LineFJAED/LineFollowerJAED/Diseño de implementación de componentes.jpeg

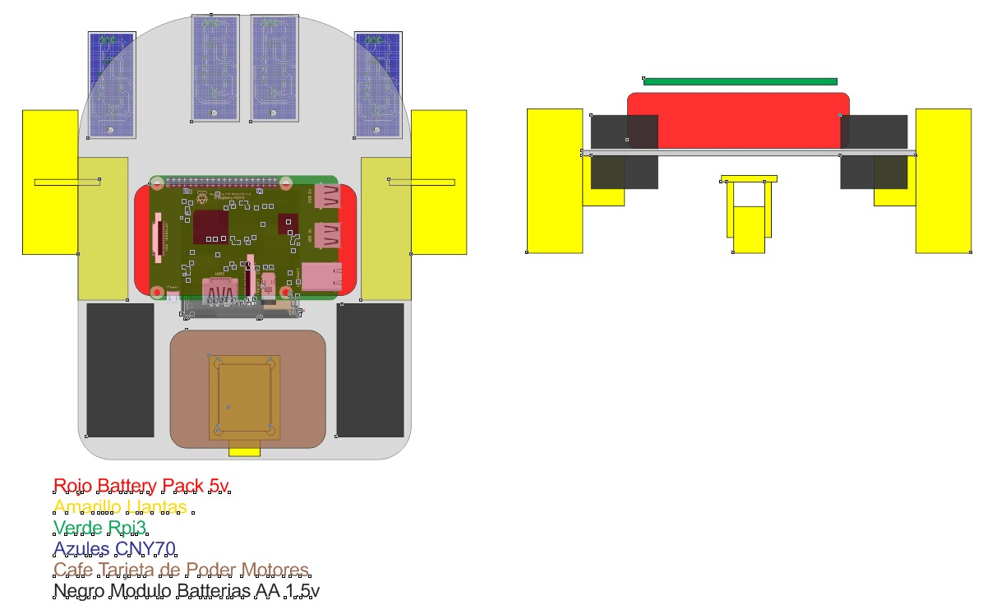
Diseño de implementación de componentes.jpeg
