LineFJAED/LineFollowerJAED/README.md

# LineFollowerJAED
Proyecto de código abierto, seguidor de línea, y proyecto de módulo.
