LineFJAED/LineFollowerJAED/Diseño de tornillos Inkscape.jpeg

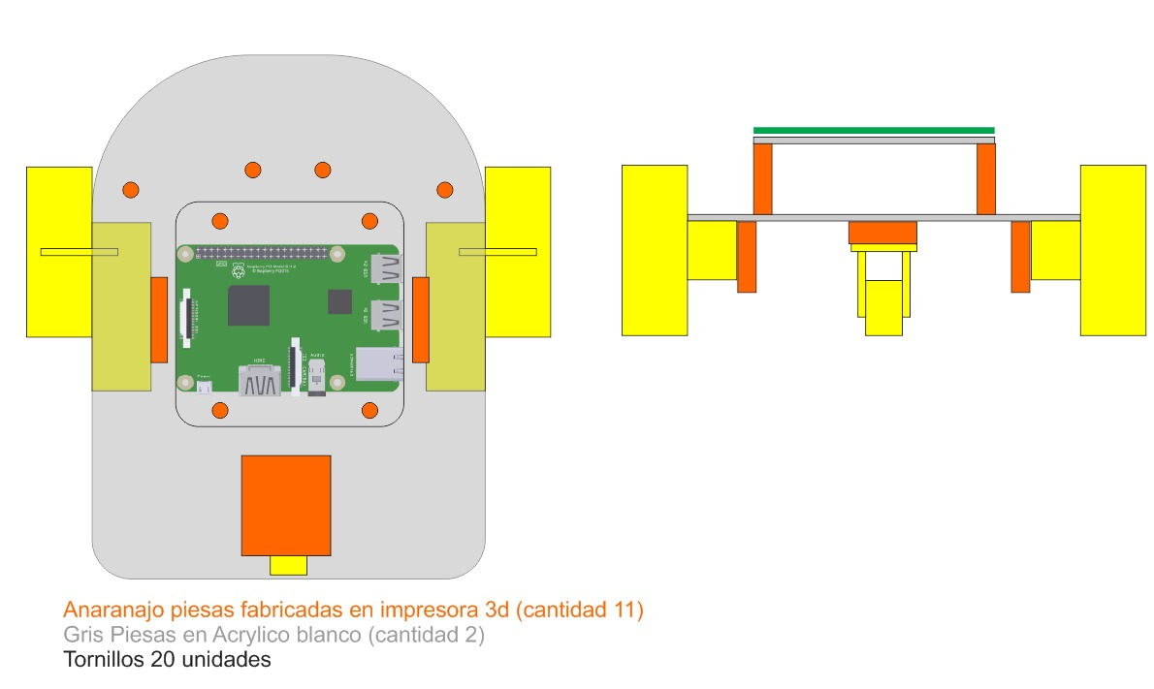
Diseño de tornillos Inkscape.jpeg
