LineFJAED/LineFollowerJAED/proyecto.pdf

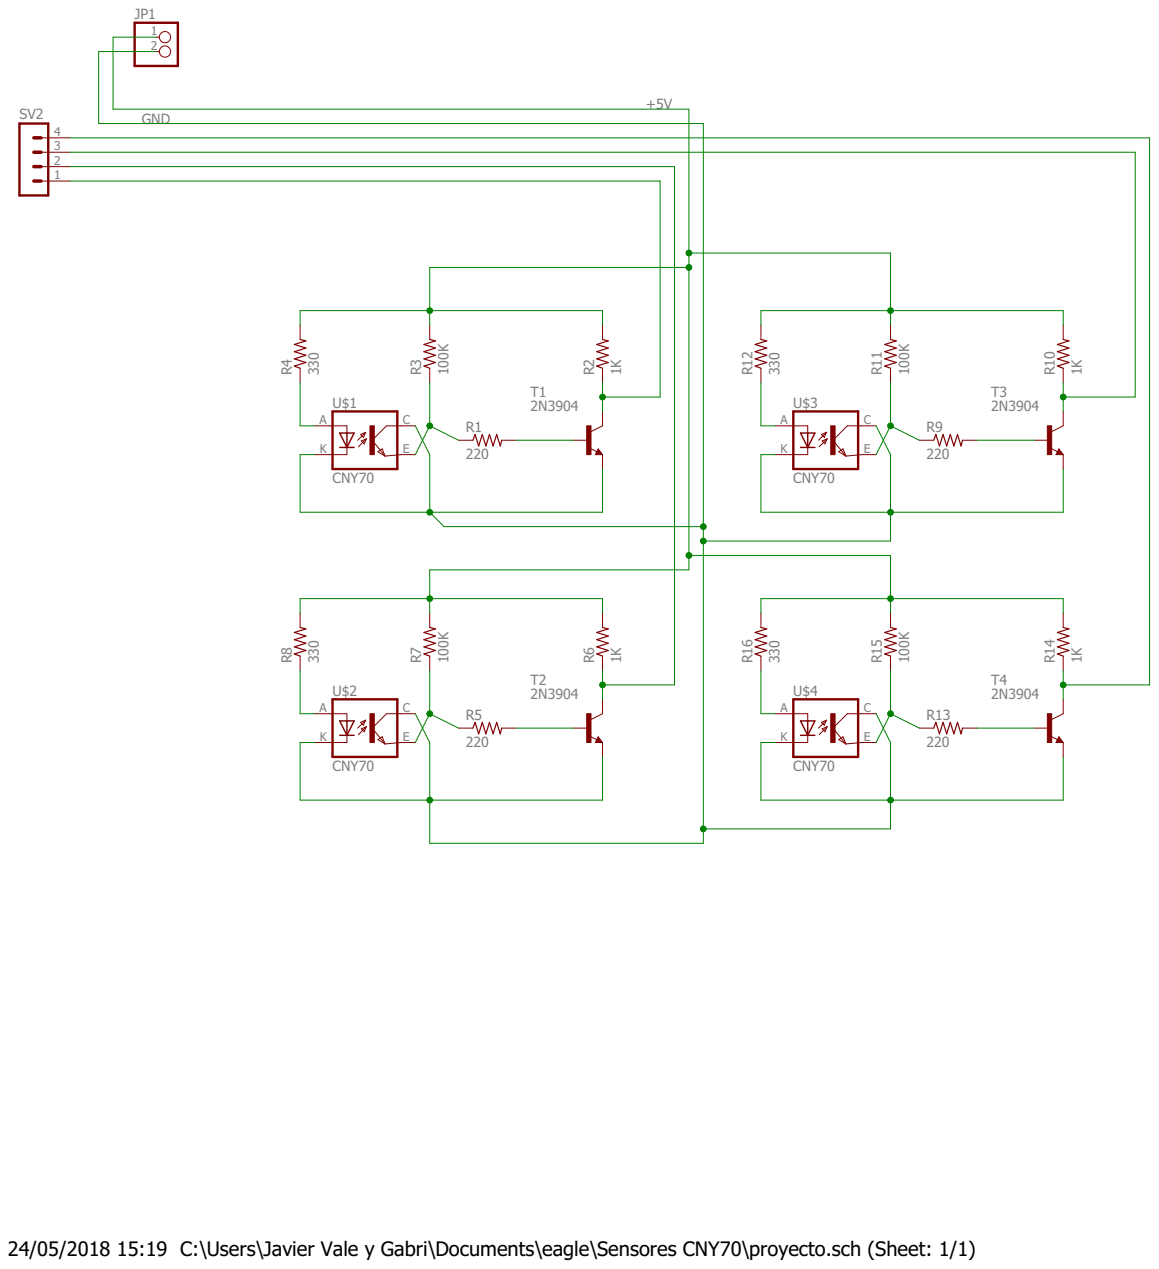
[picture p4: page 1]

24/05/2018 15:19 C:\Users\Javier Vale y Gabri\Documents\eagle\Sensores CNY70\proyecto.sch (Sheet: 1/1)
