LineFJAED/LineFollowerJAED/proyecto2.pdf

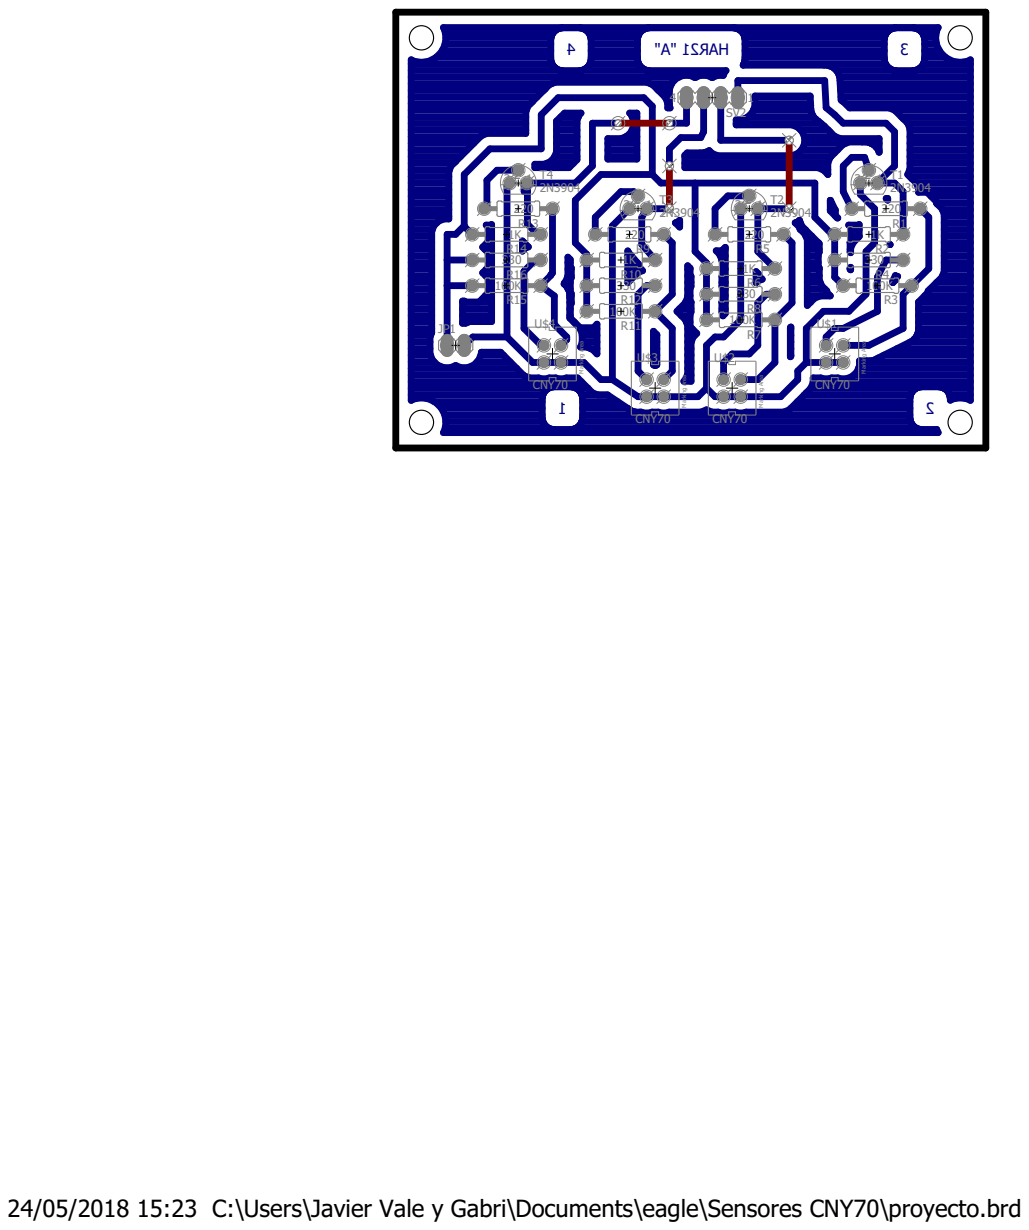
[picture p5: page 1]

24/05/2018 15:23 C:\Users\Javier Vale y Gabri\Documents\eagle\Sensores CNY70\proyecto.brd
