LineFJAED/LineFollowerJAED/PuenteH.pdf

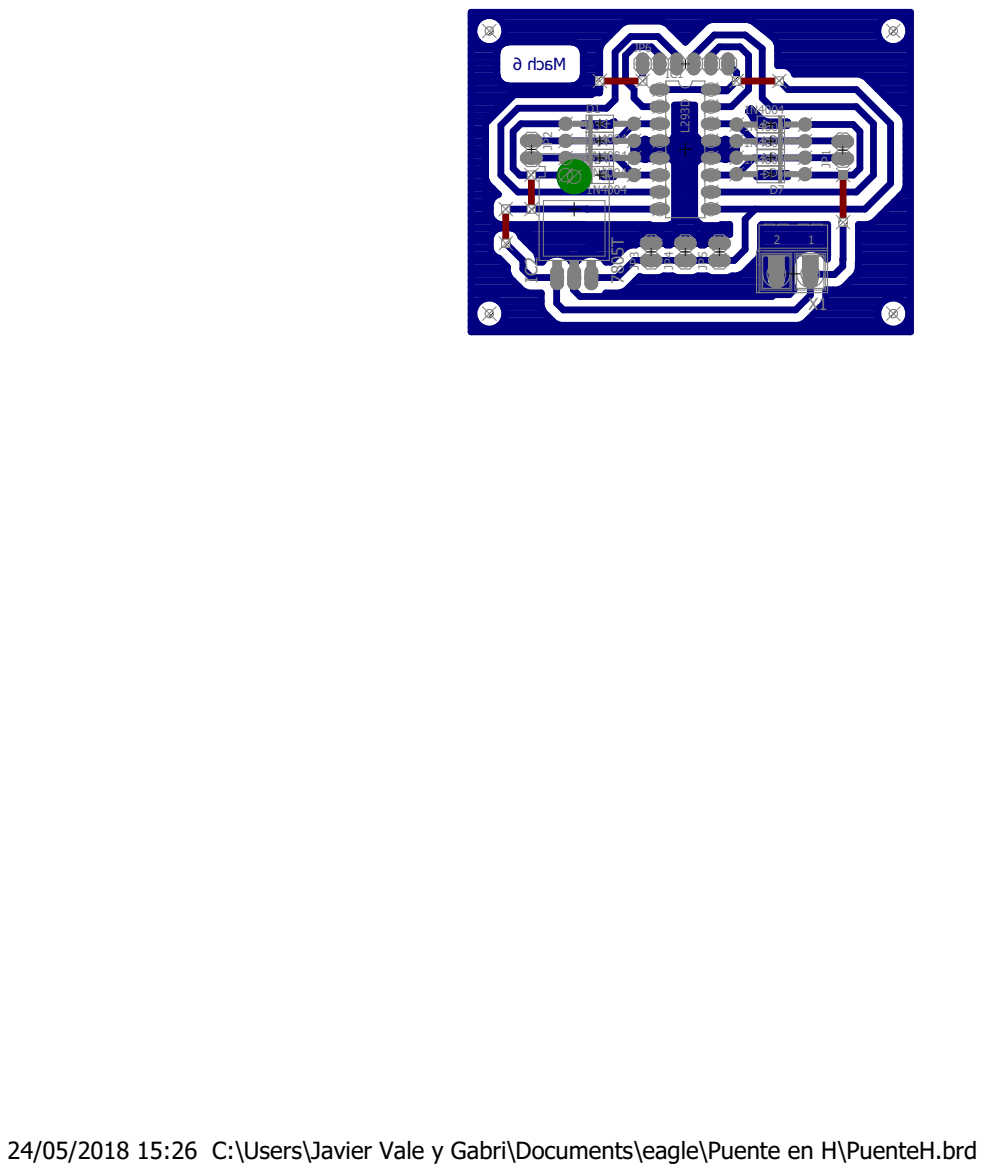
[picture p6: page 1]

24/05/2018 15:26 C:\Users\Javier Vale y Gabri\Documents\eagle\Puente en H\PuenteH.brd
