LineFJAED/LineFollowerJAED/PuenteH2.pdf

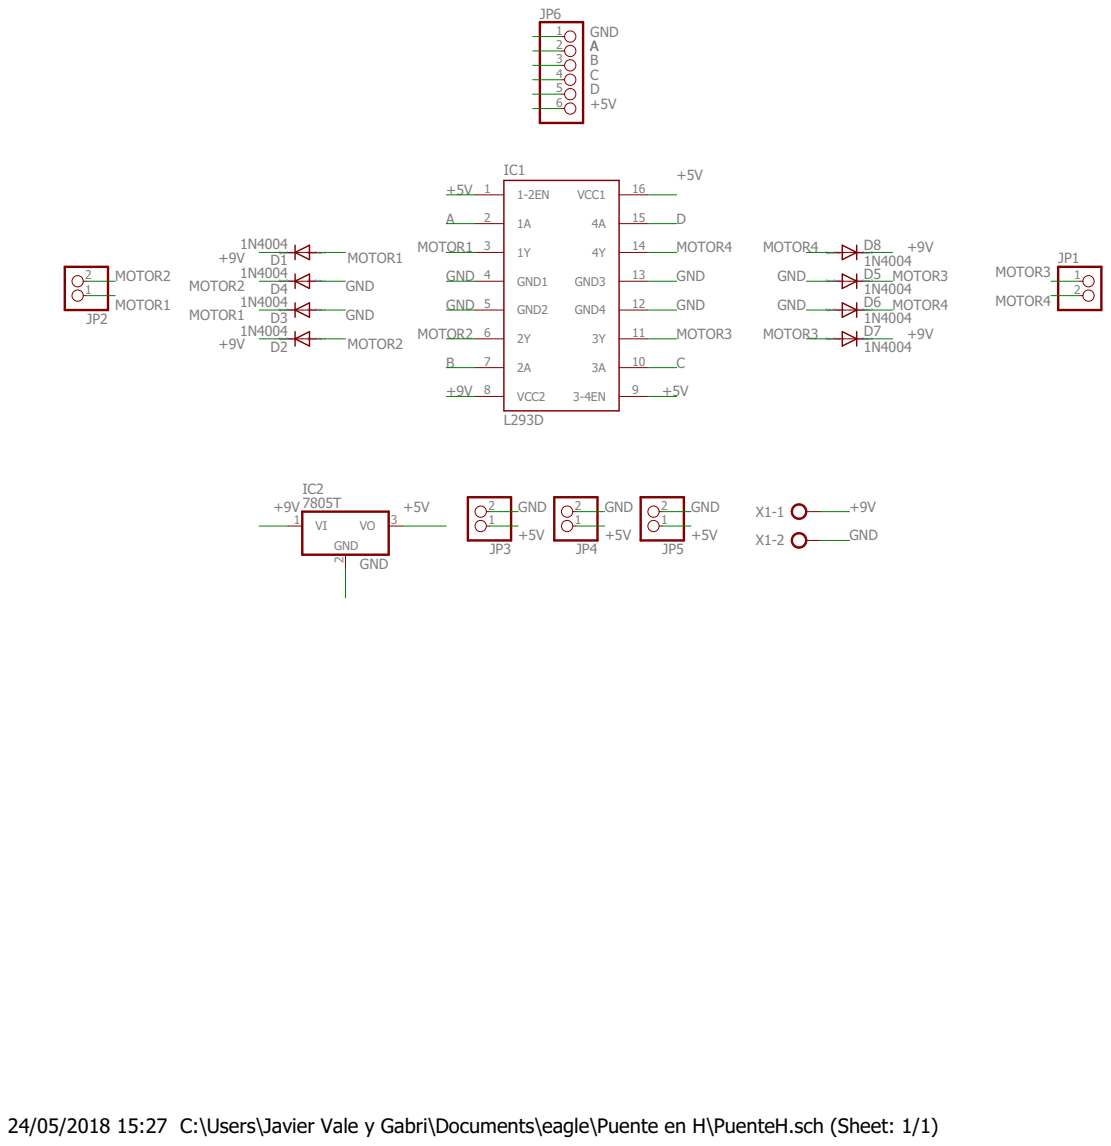
[picture p7: page 1]

24/05/2018 15:27 C:\Users\Javier Vale y Gabri\Documents\eagle\Puente en H\PuenteH.sch (Sheet: 1/1)
