LineFJAED/LineFollowerJAED/proyecto.brd

## EAGLE design proyecto.brd (2018-05-24)

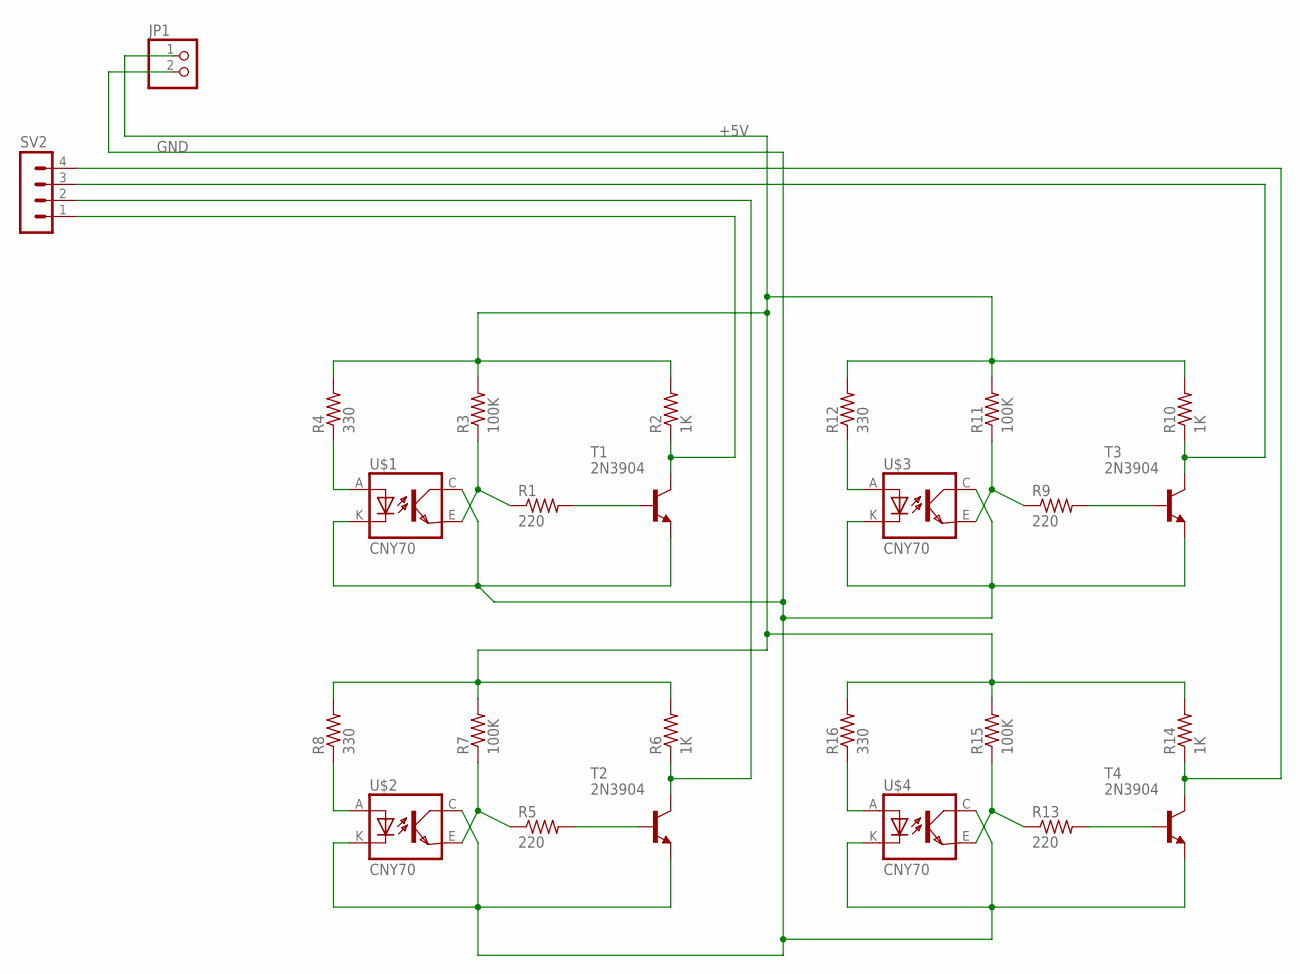
[picture p8: schematic proyecto.sch]

Parts:
JP1: PINHD-1X2; 1X02
R1, R5, R9, R13: 220; 0207/10
R2, R6, R10, R14: 1K; 0207/10
R3, R7, R11, R15: 100K; 0207/10
R4, R8, R12, R16: 330; 0207/10
SV2: MA04-1
T1, T2, T3, T4: 2N3904; TO92
U$1, U$2, U$3, U$4: CNY70; 4

Connections:
+5V: JP1.1, R2.2, R3.2, R4.2, R6.2, R7.2, R8.2, R10.2, R11.2, R12.2, R14.2, R15.2, R16.2
GND: JP1.2, T1.3 (E), T2.3 (E), T3.3 (E), T4.3 (E), U$1.C (COL), U$1.K (C), U$2.C (COL), U$2.K (C), U$3.C (COL), U$3.K (C), U$4.C (COL), U$4.K (C)
unnamed: R1.1, R3.1, U$1.E (EMI)
unnamed: R4.1, U$1.A
unnamed: R5.1, R7.1, U$2.E (EMI)
unnamed: R8.1, U$2.A
unnamed: R1.2, T1.2 (B)
unnamed: R5.2, T2.2 (B)
unnamed: R9.1, R11.1, U$3.E (EMI)
unnamed: R12.1, U$3.A
unnamed: R9.2, T3.2 (B)
unnamed: R13.1, R15.1, U$4.E (EMI)
unnamed: R16.1, U$4.A
unnamed: R13.2, T4.2 (B)
S1: R2.1, SV2.1, T1.1 (C)
S2: R6.1, SV2.2, T2.1 (C)
S3: R10.1, SV2.3, T3.1 (C)
S4: R14.1, SV2.4, T4.1 (C)

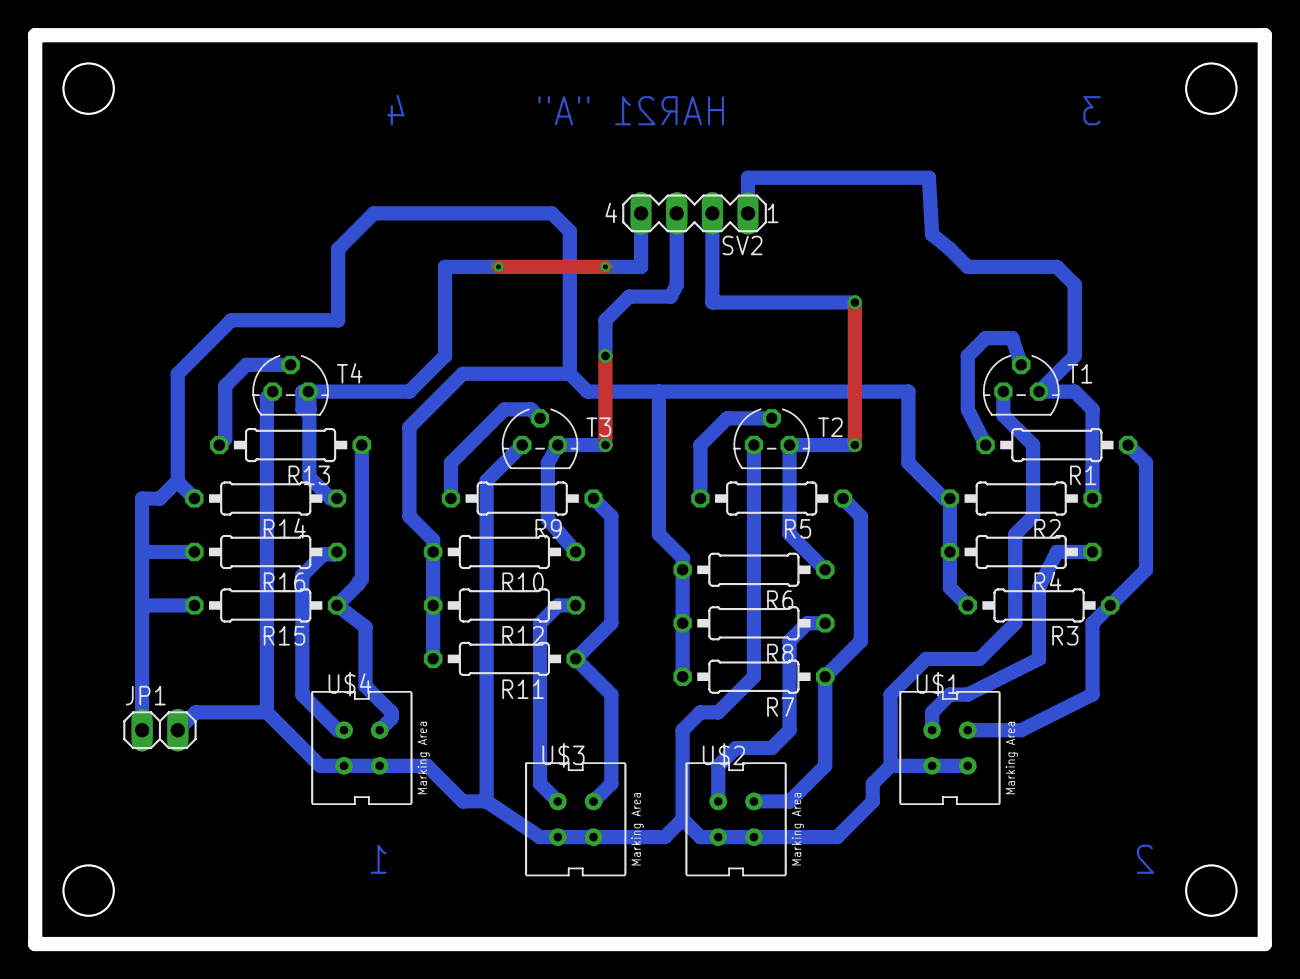
[picture p9: board proyecto.brd from above]

Board: 2 copper layers, 87.6 x 64.8 mm, 26 parts (0 on the bottom side), 18 nets.
