LineFJAED/LineFollowerJAED/PuenteH.brd

## EAGLE design PuenteH.brd (2018-05-24)

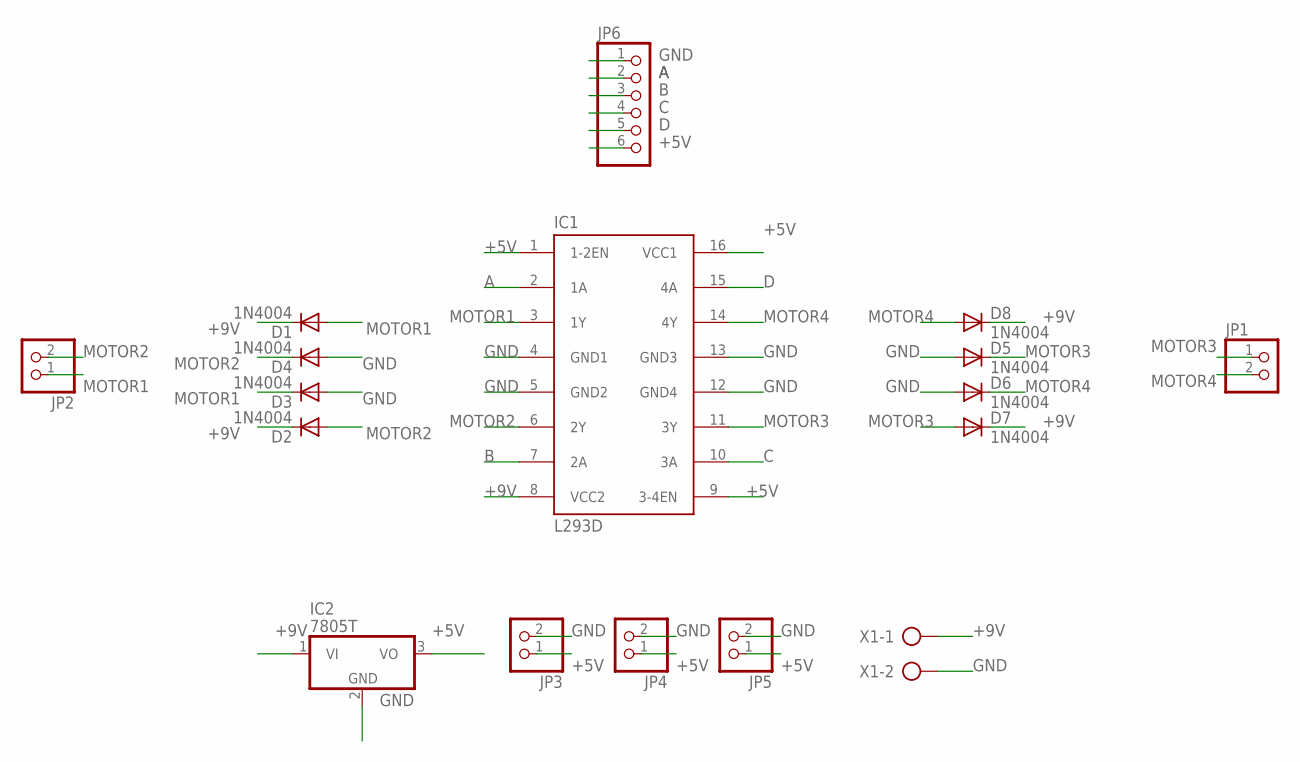
[picture p10: schematic PuenteH.sch]

Parts:
D1, D2, D3, D4, D5, D6, D7, D8: 1N4004; DO41-10
IC1: L293D; DIL16
IC2: 7805T; TO220H
JP1, JP2, JP3, JP4, JP5: PINHD-1X2; 1X02
JP6: PINHD-1X6; 1X06
X1: AK500/2-H

Connections:
+5V: IC1.1 (1-2EN), IC1.9 (3-4EN), IC1.16 (VCC1), IC2.3 (VO), JP3.1, JP4.1, JP5.1, JP6.6
+9V: D1.C, D2.C, D7.C, D8.C, IC1.8 (VCC2), IC2.1 (VI), X1.1
A: IC1.2 (1A), JP6.2
B: IC1.7 (2A), JP6.3
C: IC1.10 (3A), JP6.4
D: IC1.15 (4A), JP6.5
GND: D3.A, D4.A, D5.A, D6.A, IC1.4 (GND1), IC1.5 (GND2), IC1.12 (GND4), IC1.13 (GND3), IC2.2 (GND), JP3.2, JP4.2, JP5.2, JP6.1, X1.2
MOTOR1: D1.A, D3.C, IC1.3 (1Y), JP2.1
MOTOR2: D2.A, D4.C, IC1.6 (2Y), JP2.2
MOTOR3: D5.C, D7.A, IC1.11 (3Y), JP1.1
MOTOR4: D6.C, D8.A, IC1.14 (4Y), JP1.2

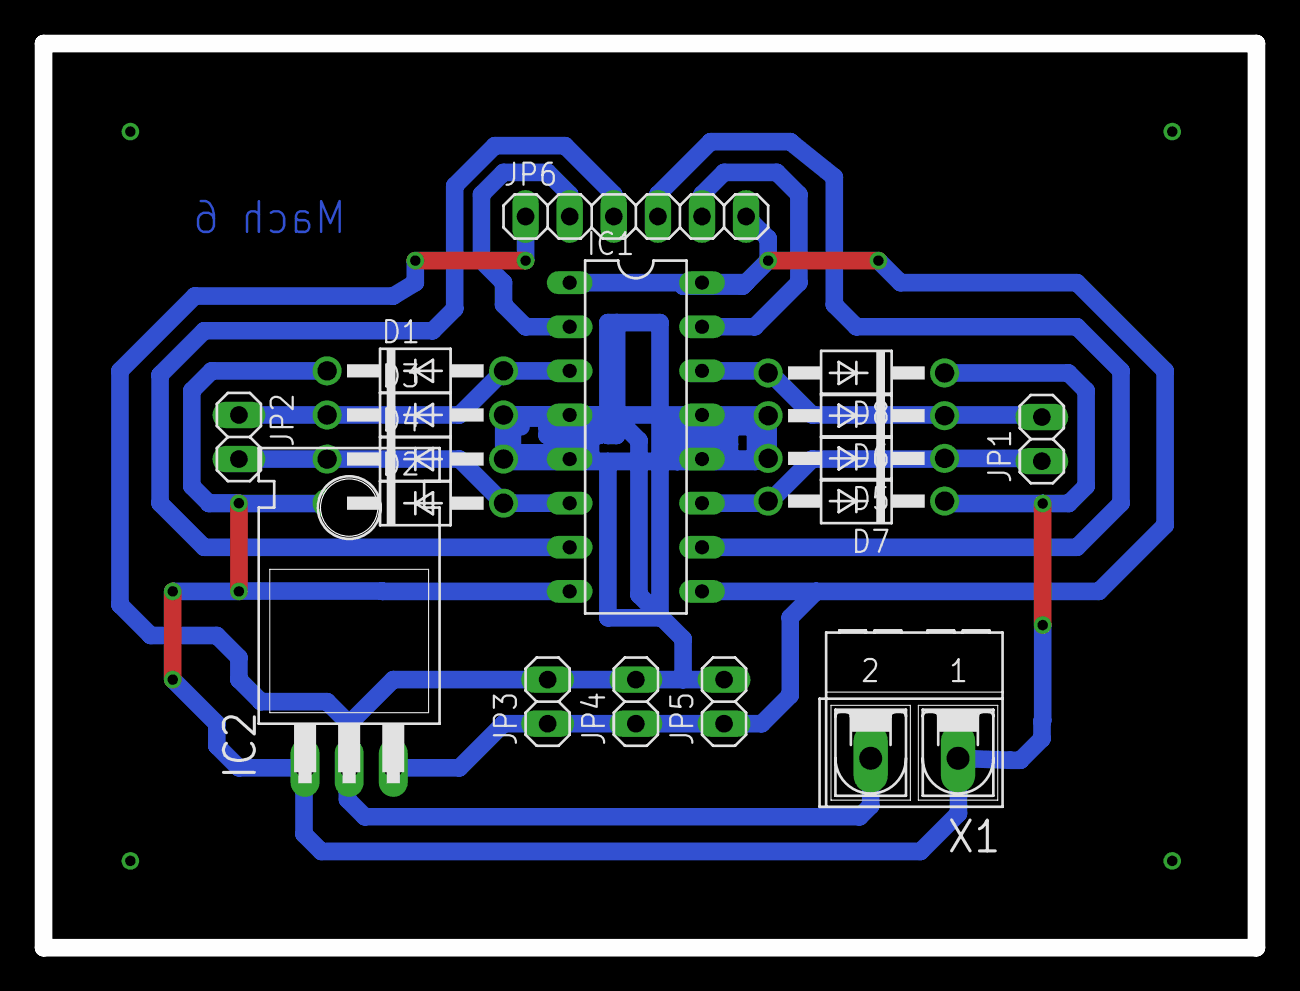
[picture p11: board PuenteH.brd from above]

Board: 2 copper layers, 69.8 x 52.1 mm, 17 parts (0 on the bottom side), 11 nets.
