LineFJAED/LineFollowerJAED/(commit log)

2018-05-24 Puente H
    Driver para motores a utilizar en el proyecto
    [PuenteH.brd, PuenteH.sch]
2018-05-24 Módulo CNY70
    Sensor de luz del seguidor de linea
    [proyecto.brd, proyecto.sch]
2018-05-24 Cambio 1 Puente
    Adición de agujeros
    [PuenteH.brd, PuenteH.sch]
2018-05-24 Primer cambio en sensores
    [proyecto.brd, proyecto.sch]
2018-06-07 Codigo del proyecto
    Lenguaje de programación: Python
    Placa de desarrollo: Raspberry Pi 3 B+
2018-06-13 Ultimos cambios del seguidor de linea
    Se agregan el diseño del chasis, el código final se modifica y se agrega en paper del seguidor de linea
